kairyu/kimera/kimera_origin/doc/Kimera_v1_schema.png

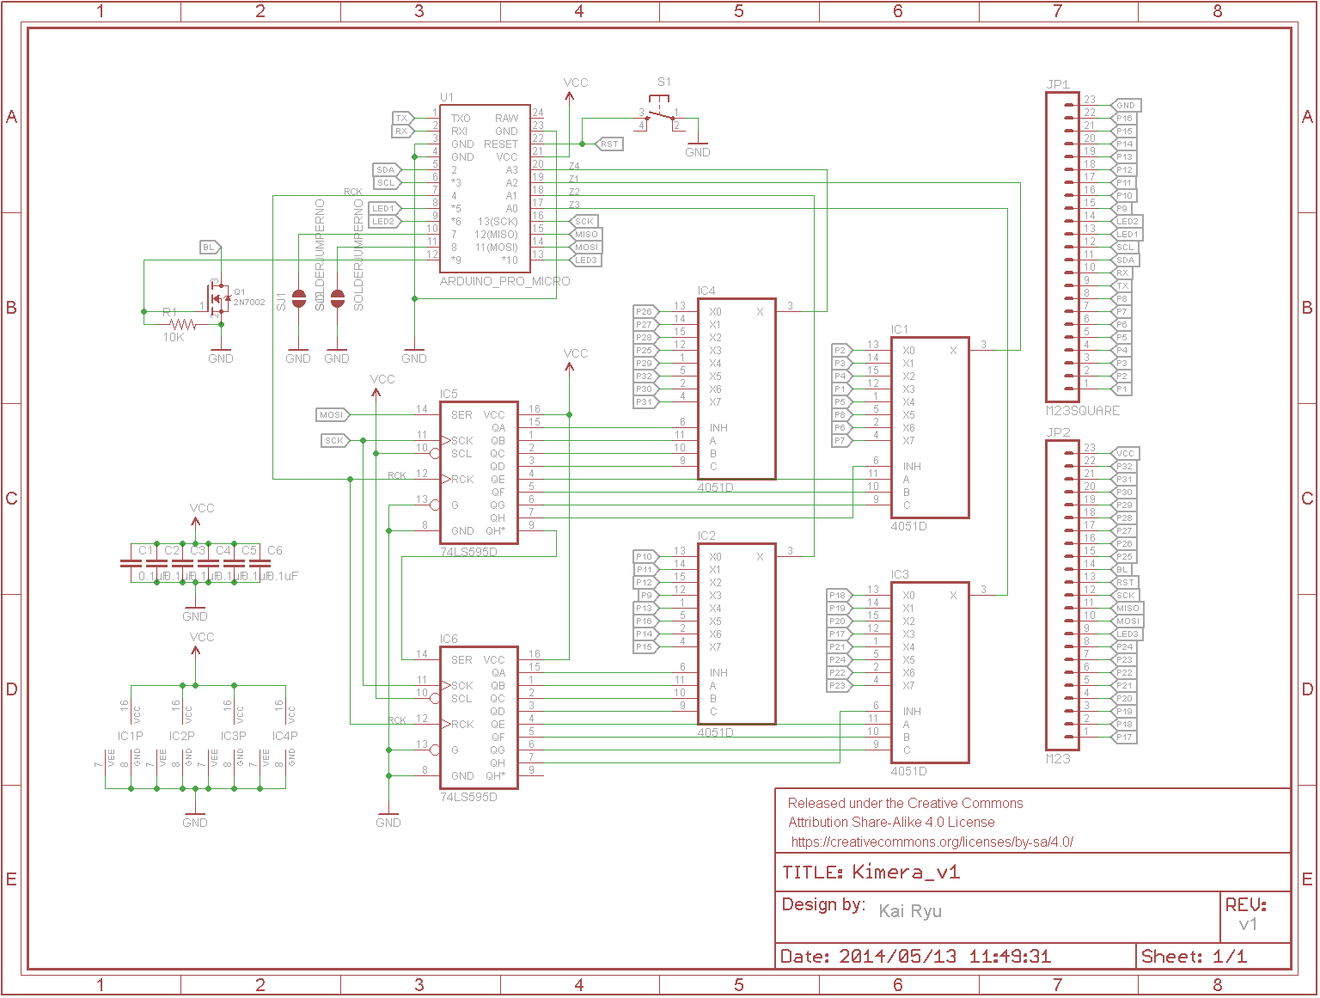
kimera_origin/doc/Kimera_v1_schema.png
