kairyu/kimera/kimera_core/v1.0/hardware/schematic/Kimera_core_v1.0_schematic.pdf

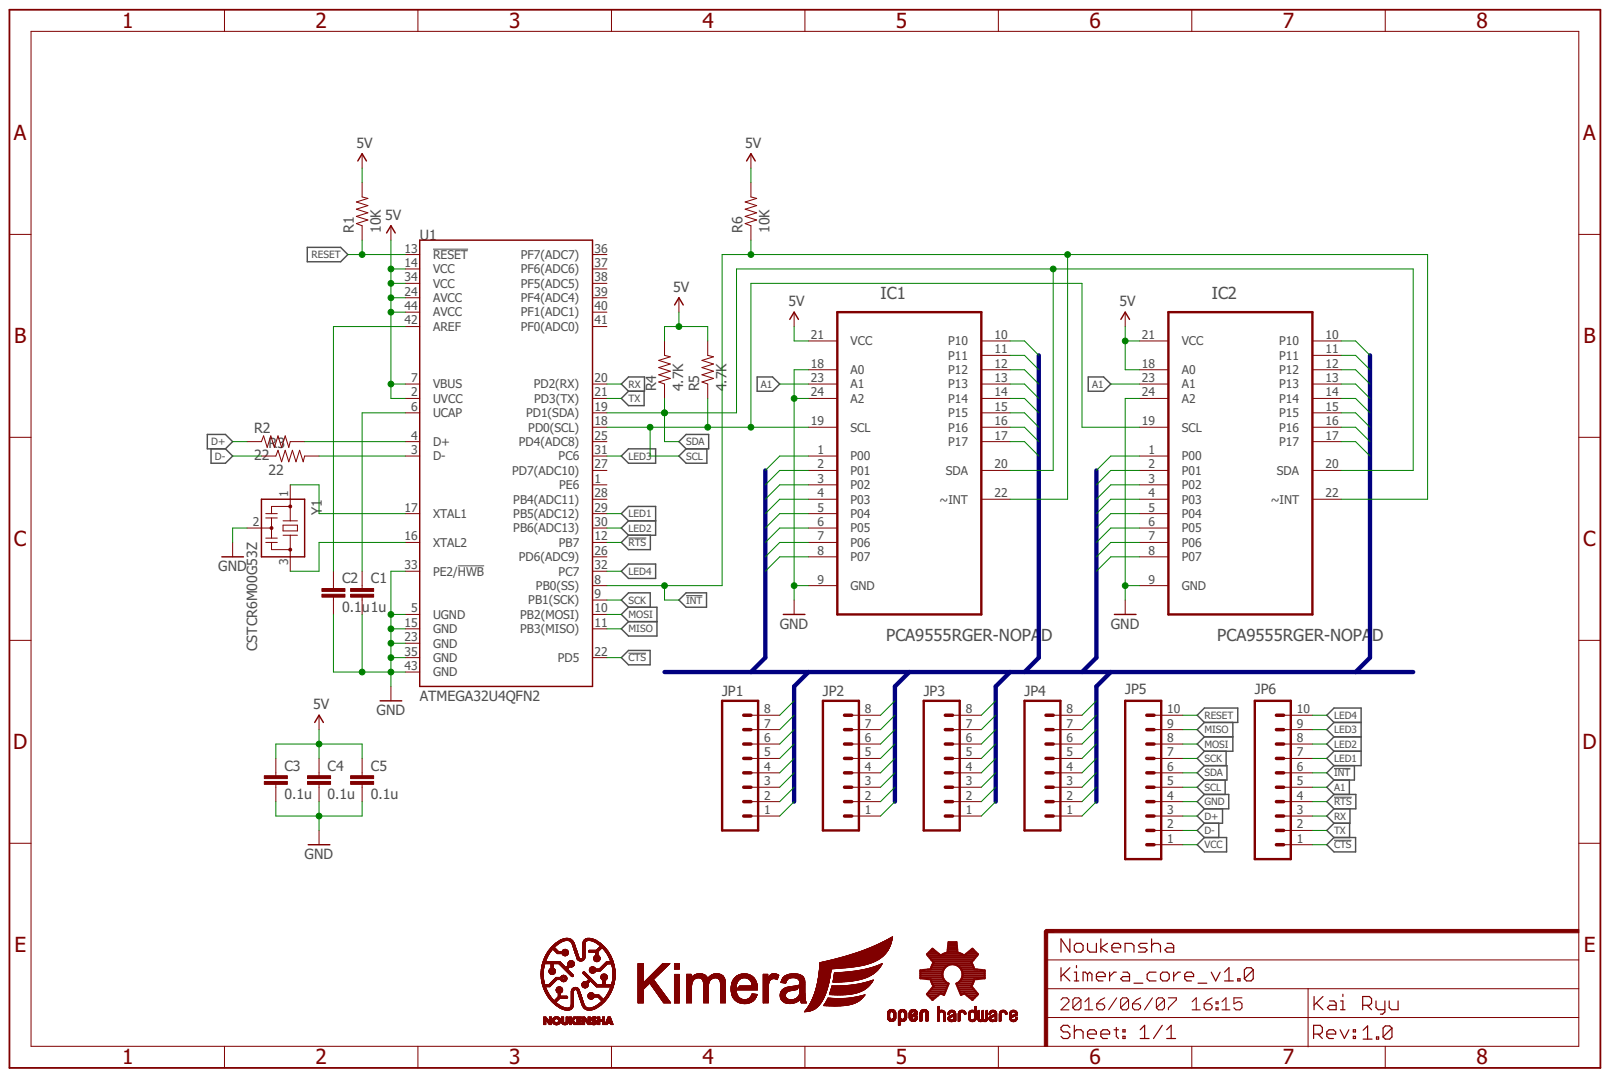
[picture p3: page 1]
