kairyu/kimera/kimera_origin/doc/Kimera_v1_schema.pdf

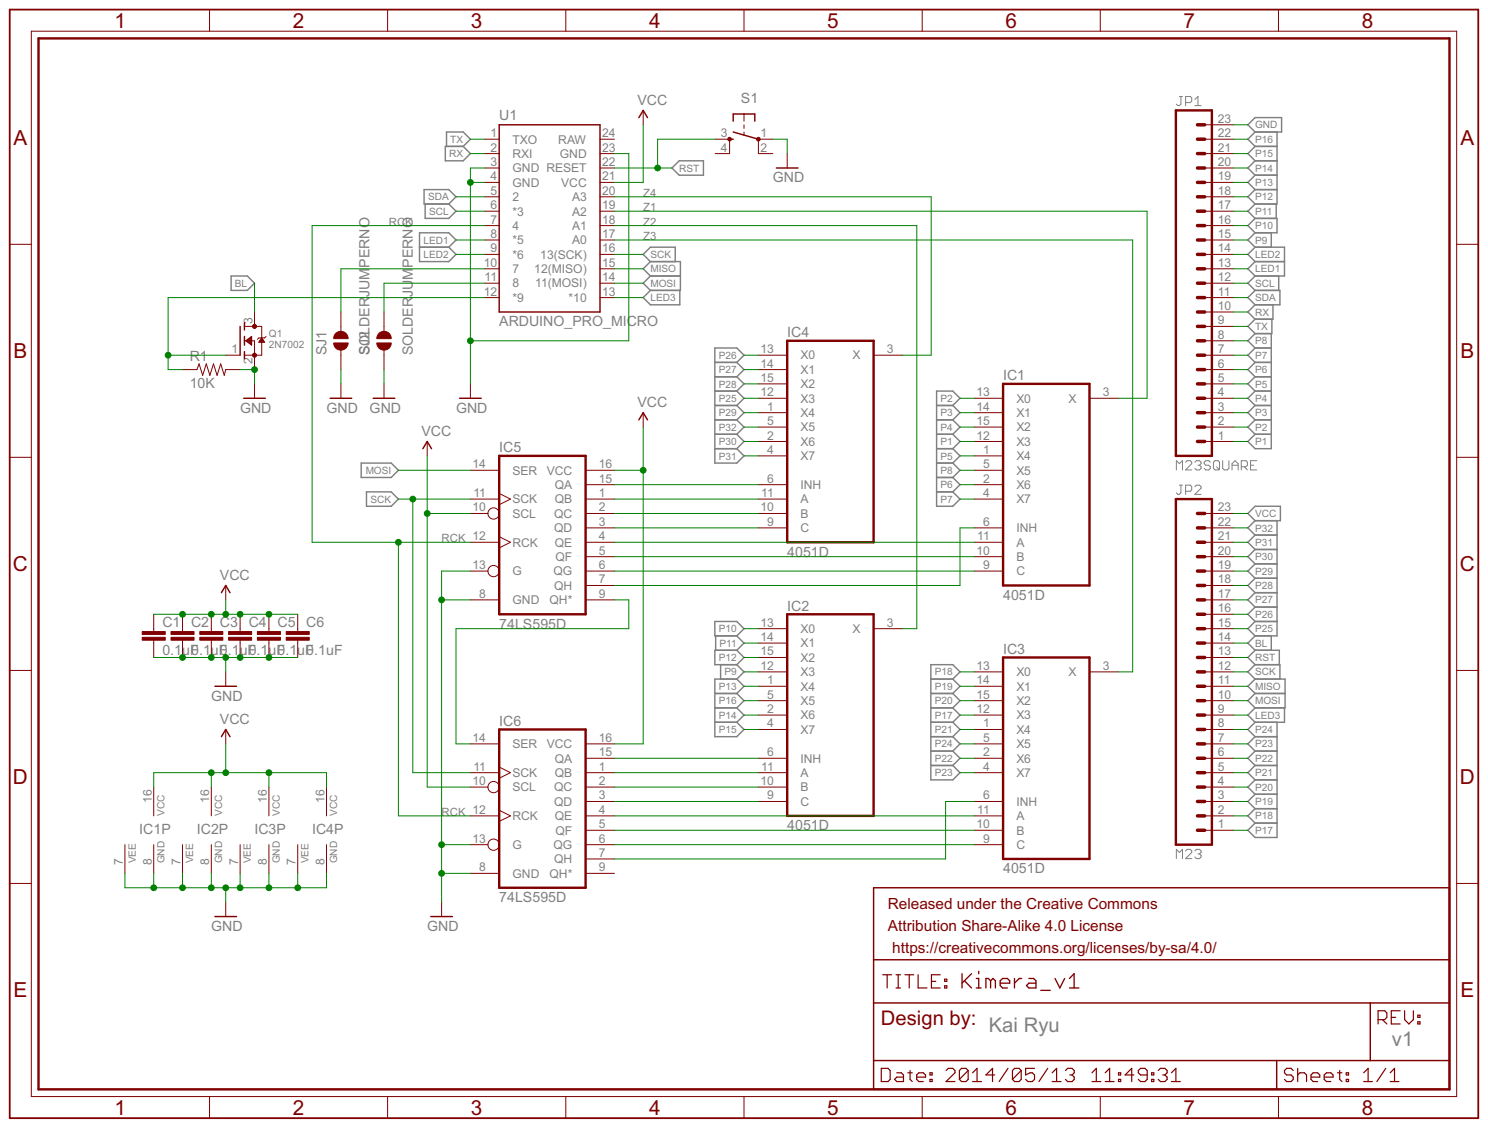
[picture p4: page 1]
