kairyu/kimera/kimera_core/v1.0/hardware/eagle/Kimera_core_v1.0.brd

## EAGLE design kimera_core/v1.0/hardware/eagle/Kimera_core_v1.0.brd (2016-06-07)

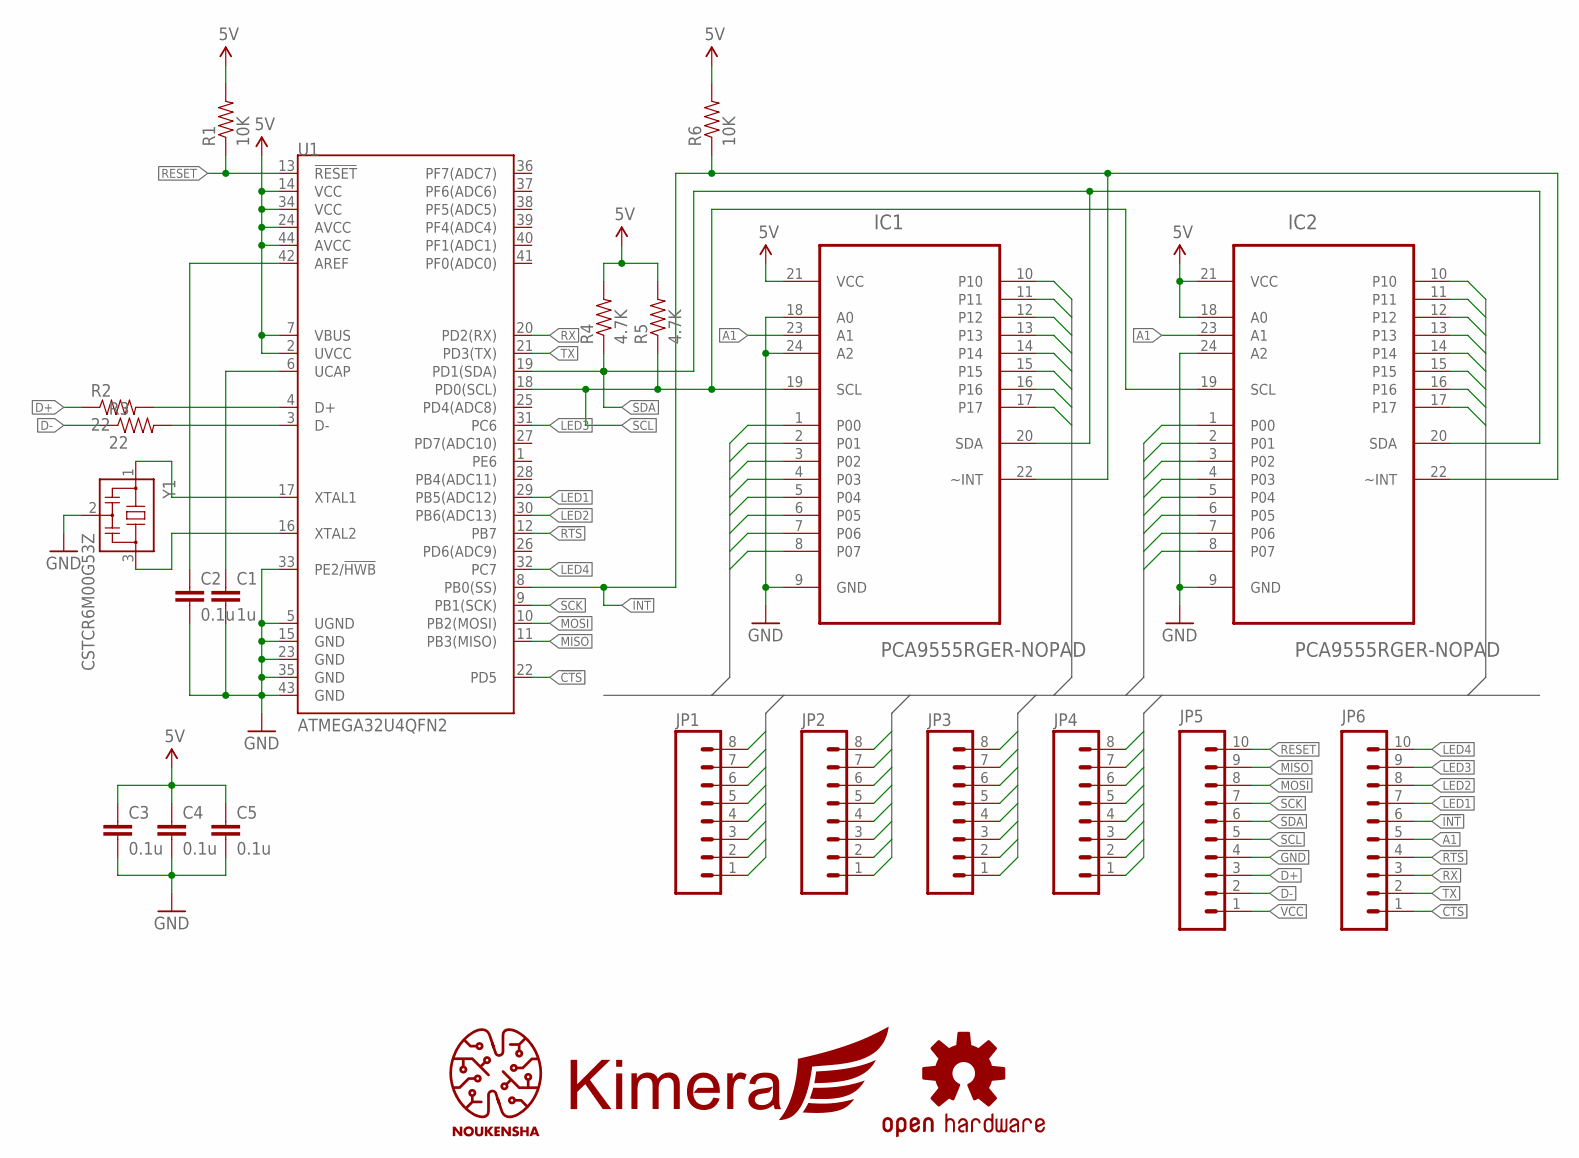
[picture p5: schematic Kimera_core_v1.0.sch]

Parts:
C1: 1u; 0402-CAP
C2, C3, C4, C5: 0.1u; 0402-CAP
IC1, IC2: PCA9555RGER-NOPAD; QFN50P400X400X100-25N-NOPAD
JP1, JP2, JP3, JP4: P08
JP5, JP6: P10
LOGO1: KIMERA_LOGO
LOGO2: NOUKENSHA_LOGONIX; NOUKENSHA_LOGO_NIX
LOGO3: OSHW_LOGONIX; OSHW_LOGO_NIX
R1, R6: 10K; 0402-RES
R2, R3: 22; 0402-RES
R4, R5: 4.7K; 0402-RES
U1: ATMEGA32U4QFN2; QFN-44-NOPAD
Y1: CSTCR6M00G53Z; CSTER12M

Connections:
!CTS: JP6.1, U1.22 (PD5)
!INT: IC1.22 (~INT), IC2.22 (~INT), JP6.6, R6.1, U1.8 (PB0(SS))
!RTS: JP6.4, U1.12 (PB7)
A1: IC1.23 (A1), IC2.23 (A1), JP6.5
D+: JP5.3, R2.1
D-: JP5.2, R3.1
GND: C1.2, C2.2, C3.2, C4.2, C5.2, IC1.9 (GND), IC1.18 (A0), IC1.24 (A2), IC2.9 (GND), IC2.24 (A2), JP5.4, U1.5 (UGND), U1.15 (GND), U1.23 (GND), U1.33 (PE2/!HWB), U1.35 (GND), U1.43 (GND), Y1.2
LED1: JP6.7, U1.29 (PB5(ADC12))
LED2: JP6.8, U1.30 (PB6(ADC13))
LED3: JP6.9, U1.31 (PC6)
LED4: JP6.10, U1.32 (PC7)
MISO: JP5.9, U1.11 (PB3(MISO))
MOSI: JP5.8, U1.10 (PB2(MOSI))
unnamed: C2.1, U1.42 (AREF)
unnamed: R2.2, U1.4 (D+)
unnamed: U1.17 (XTAL1), Y1.1
unnamed: U1.16 (XTAL2), Y1.3
unnamed: R3.2, U1.3 (D-)
unnamed: C1.1, U1.6 (UCAP)
P1: IC1.1 (P00), JP1.1
P2: IC1.2 (P01), JP1.2
P3: IC1.3 (P02), JP1.3
P4: IC1.4 (P03), JP1.4
P5: IC1.5 (P04), JP1.5
P6: IC1.6 (P05), JP1.6
P7: IC1.7 (P06), JP1.7
P8: IC1.8 (P07), JP1.8
P9: IC1.10, JP2.1
P10: IC1.11, JP2.2
P11: IC1.12, JP2.3
P12: IC1.13, JP2.4
P13: IC1.14, JP2.5
P14: IC1.15, JP2.6
P15: IC1.16, JP2.7
P16: IC1.17, JP2.8
P17: IC2.1 (P00), JP3.1
P18: IC2.2 (P01), JP3.2
P19: IC2.3 (P02), JP3.3
P20: IC2.4 (P03), JP3.4
P21: IC2.5 (P04), JP3.5
P22: IC2.6 (P05), JP3.6
P23: IC2.7 (P06), JP3.7
P24: IC2.8 (P07), JP3.8
P25: IC2.10, JP4.1
P26: IC2.11, JP4.2
P27: IC2.12, JP4.3
P28: IC2.13, JP4.4
P29: IC2.14, JP4.5
P30: IC2.15, JP4.6
P31: IC2.16, JP4.7
P32: IC2.17, JP4.8
RESET: JP5.10, R1.1, U1.13 (!RESET)
RX: JP6.3, U1.20 (PD2(RX))
SCK: JP5.7, U1.9 (PB1(SCK))
SCL: IC1.19 (SCL), IC2.19 (SCL), JP5.5, R5.1, U1.18 (PD0(SCL))
SDA: IC1.20 (SDA), IC2.20 (SDA), JP5.6, R4.1, U1.19 (PD1(SDA))
TX: JP6.2, U1.21 (PD3(TX))
VCC: C3.1, C4.1, C5.1, IC1.21 (VCC), IC2.18 (A0), IC2.21 (VCC), JP5.1, R1.2, R4.2, R5.2, R6.2, U1.2 (UVCC), U1.7 (VBUS), U1.14 (VCC), U1.24 (AVCC), U1.34 (VCC), U1.44 (AVCC)

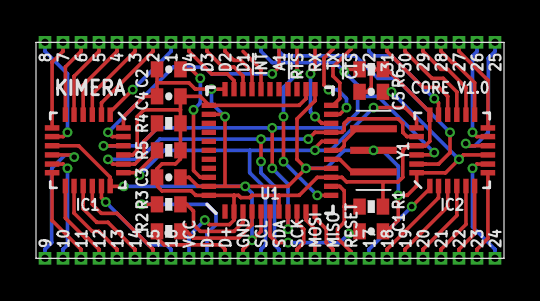
[picture p6: board Kimera_core_v1.0.brd from above]

Board: 2 copper layers, 26.0 x 12.0 mm, 24 parts (1 on the bottom side), 58 nets.
