kairyu/kimera/(threads)

Thread 1 (2017-05-27):

Design will be make pin short to GND

hging, 2017-05-27:
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
I think these through hole is easy to stuffed tin.
Then will make pin short GND that below the 9555.
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
