kairyu/kimera/(commit log)

2014-06-09 Add schematic file of kimera v1
2014-06-17 Add a image version of schematic
2016-06-07 kimera_core: Initial schematic and layout of v1.0
    [Kimera_core_v1.0.brd, Kimera_core_v1.0.sch]
2016-06-07 kimera_core: Change bus and layout
    [Kimera_core_v1.0.brd, Kimera_core_v1.0.sch]
2016-06-07 kimera_core: Change basic layout and route a part of io
    [Kimera_core_v1.0.brd, Kimera_core_v1.0.sch]
2016-06-07 kimera_core: Assign main io and route more io
    [Kimera_core_v1.0.brd, Kimera_core_v1.0.sch]
2016-06-07 kimera_core: Change element location and castellated holes
    [Kimera_core_v1.0.brd, Kimera_core_v1.0.sch]
2016-06-07 kimera_core: Reduce board size and remove some main io
    [Kimera_core_v1.0.brd, Kimera_core_v1.0.sch]
2016-06-07 kimera_core: First complete version - Finish routing - Add logo and silk screen
    [Kimera_core_v1.0.brd, Kimera_core_v1.0.sch]
2016-06-07 kimera_core: Add production files
    [Kimera_core_v1.0.brd, Kimera_core_v1.0.sch, Kimera_core_v1.0_bom.csv]
2016-06-07 kimera_core: Change signal name of LED pins
    [Kimera_core_v1.0.brd, Kimera_core_v1.0.sch]
2016-06-07 kimera_core: Add schematic files
